Project-Aurora/RainbowFox/RainbowFox.kicad_pcb

## KiCad design RainbowFox.kicad_pcb (2016-12-02)

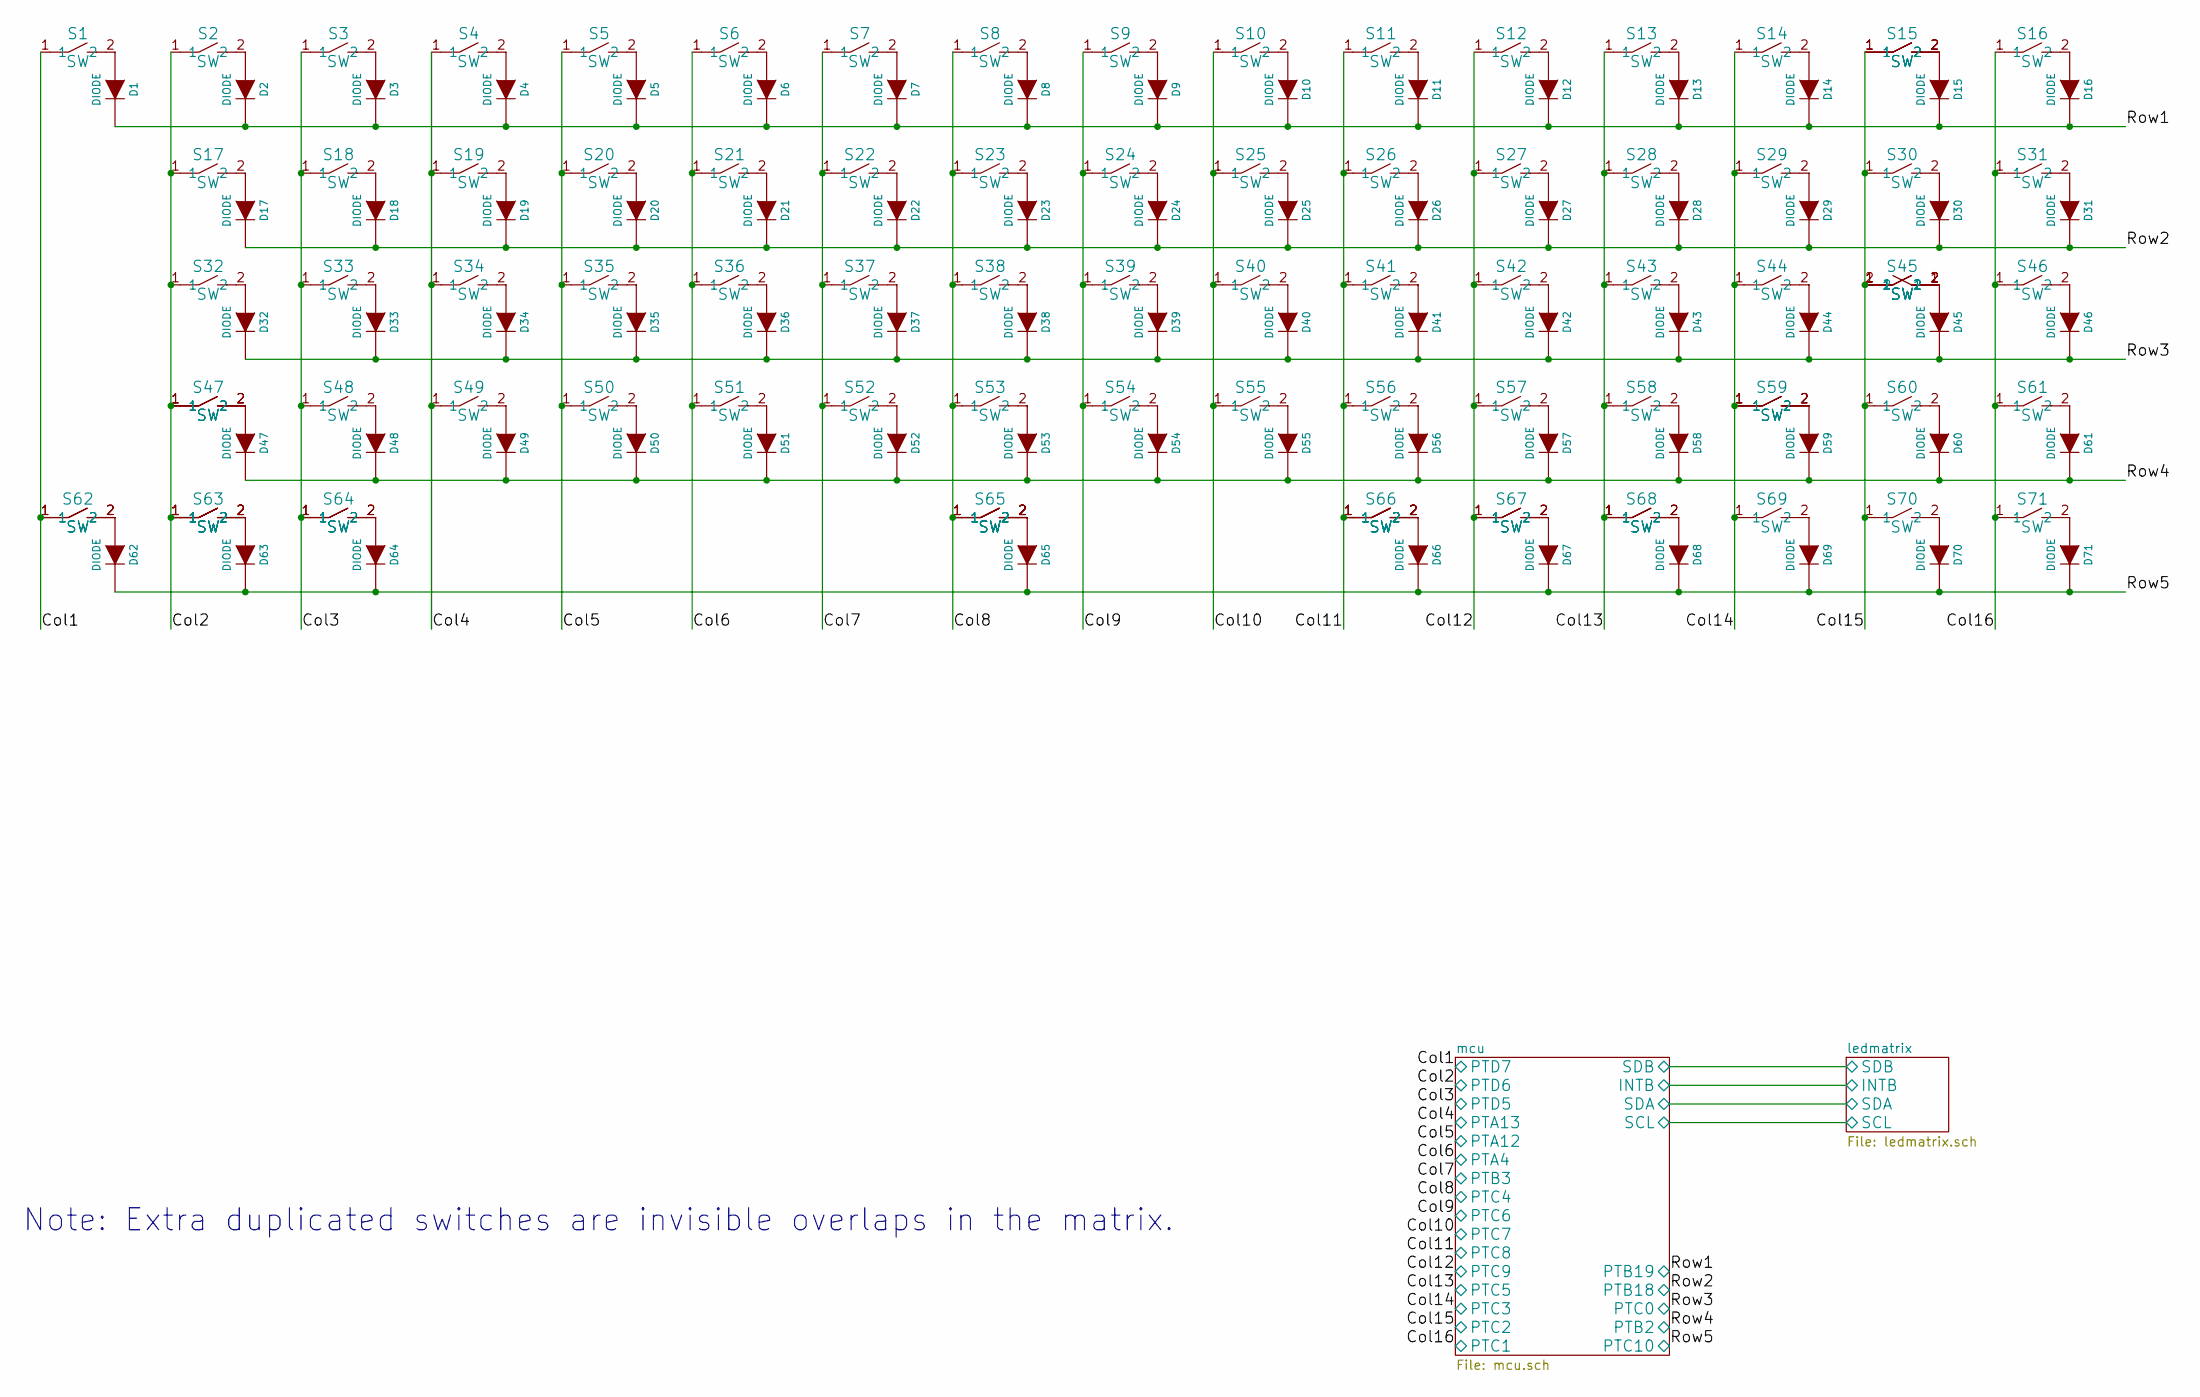
[picture p1: schematic RainbowFox.sch]

Parts:
D1, D2, D3, D4, D5, D6, D7, D8, D9, D10, D11, D12, D13, D14, D15, D16, D17, D18, D19, D20, D21, D22, D23, D24, D25, D26, D27, D28, D29, D30, D31, D32, D33, D34, D35, D36, D37, D38, D39, D40, D41, D42, D43, D44, D45, D46, D47, D48, D49, D50, D51, D52, D53, D54, D55, D56, D57, D58, D59, D60, D61, D62, D63, D64, D65, D66, D67, D68, D69, D70, D71: DIODE; SOD-123
S1, S2, S3, S4, S5, S6, S7, S8, S9, S10, S11, S12, S13, S14, S15, S16, S17, S18, S19, S20, S21, S22, S23, S24, S25, S26, S27, S28, S29, S30, S31, S32, S33, S34, S35, S36, S37, S38, S39, S40, S41, S42, S43, S44, S45, S46, S47, S48, S49, S50, S51, S52, S53, S54, S55, S56, S57, S58, S59, S60, S61, S62, S63, S64, S65, S66, S67, S68, S69, S70, S71: SW; MX1A
S115, S145, S147, S159, S162, S163, S164, S165, S166, S167, S168, S245, S263, S265, S266: SW; MX1A-Borderless

Connections:
/mcu/PTA4: S6.1, S21.1, S36.1, S51.1; also elsewhere on the board
/mcu/PTA12: S5.1, S20.1, S35.1, S50.1; also elsewhere on the board
/mcu/PTA13: S4.1, S19.1, S34.1, S49.1; also elsewhere on the board
/mcu/PTB2: D47.1 (K), D48.1 (K), D49.1 (K), D50.1 (K), D51.1 (K), D52.1 (K), D53.1 (K), D54.1 (K), D55.1 (K), D56.1 (K), D57.1 (K), D58.1 (K), D59.1 (K), D60.1 (K), D61.1 (K); also elsewhere on the board
/mcu/PTB3: S7.1, S22.1, S37.1, S52.1; also elsewhere on the board
/mcu/PTB18: D17.1 (K), D18.1 (K), D19.1 (K), D20.1 (K), D21.1 (K), D22.1 (K), D23.1 (K), D24.1 (K), D25.1 (K), D26.1 (K), D27.1 (K), D28.1 (K), D29.1 (K), D30.1 (K), D31.1 (K); also elsewhere on the board
/mcu/PTB19: D1.1 (K), D2.1 (K), D3.1 (K), D4.1 (K), D5.1 (K), D6.1 (K), D7.1 (K), D8.1 (K), D9.1 (K), D10.1 (K), D11.1 (K), D12.1 (K), D13.1 (K), D14.1 (K), D15.1 (K), D16.1 (K); also elsewhere on the board
/mcu/PTC0: D32.1 (K), D33.1 (K), D34.1 (K), D35.1 (K), D36.1 (K), D37.1 (K), D38.1 (K), D39.1 (K), D40.1 (K), D41.1 (K), D42.1 (K), D43.1 (K), D44.1 (K), D45.1 (K), D46.1 (K); also elsewhere on the board
/mcu/PTC1: S16.1, S31.1, S46.1, S61.1, S71.1; also elsewhere on the board
/mcu/PTC2: S15.1, S30.1, S45.1, S60.1, S70.1, S115.1, S145.1, S245.2; also elsewhere on the board
/mcu/PTC3: S14.1, S29.1, S44.1, S59.1, S69.1, S159.1; also elsewhere on the board
/mcu/PTC4: S8.1, S23.1, S38.1, S53.1, S65.1, S165.1, S265.1; also elsewhere on the board
/mcu/PTC5: S13.1, S28.1, S43.1, S58.1, S68.1, S168.1; also elsewhere on the board
/mcu/PTC6: S9.1, S24.1, S39.1, S54.1; also elsewhere on the board
/mcu/PTC7: S10.1, S25.1, S40.1, S55.1; also elsewhere on the board
/mcu/PTC8: S11.1, S26.1, S41.1, S56.1, S66.1, S166.1, S266.1; also elsewhere on the board
/mcu/PTC9: S12.1, S27.1, S42.1, S57.1, S67.1, S167.1; also elsewhere on the board
/mcu/PTC10: D62.1 (K), D63.1 (K), D64.1 (K), D65.1 (K), D66.1 (K), D67.1 (K), D68.1 (K), D69.1 (K), D70.1 (K), D71.1 (K); also elsewhere on the board
/mcu/PTD5: S3.1, S18.1, S33.1, S48.1, S64.1, S164.1; also elsewhere on the board
/mcu/PTD6: S2.1, S17.1, S32.1, S47.1, S63.1, S147.1, S163.1, S263.1; also elsewhere on the board
/mcu/PTD7: S1.1, S62.1, S162.1; also elsewhere on the board
unnamed: D1.2 (A), S1.2
unnamed: D2.2 (A), S2.2
unnamed: D3.2 (A), S3.2
unnamed: D4.2 (A), S4.2
unnamed: D5.2 (A), S5.2
unnamed: D6.2 (A), S6.2
unnamed: D7.2 (A), S7.2
unnamed: D8.2 (A), S8.2
unnamed: D9.2 (A), S9.2
unnamed: D10.2 (A), S10.2
unnamed: D11.2 (A), S11.2
unnamed: D12.2 (A), S12.2
unnamed: D13.2 (A), S13.2
unnamed: D14.2 (A), S14.2
unnamed: D15.2 (A), S15.2, S115.2
unnamed: D16.2 (A), S16.2
unnamed: D17.2 (A), S17.2
unnamed: D18.2 (A), S18.2
unnamed: D19.2 (A), S19.2
unnamed: D20.2 (A), S20.2
unnamed: D21.2 (A), S21.2
unnamed: D22.2 (A), S22.2
unnamed: D23.2 (A), S23.2
unnamed: D24.2 (A), S24.2
unnamed: D25.2 (A), S25.2
unnamed: D26.2 (A), S26.2
unnamed: D27.2 (A), S27.2
unnamed: D28.2 (A), S28.2
unnamed: D29.2 (A), S29.2
unnamed: D30.2 (A), S30.2
unnamed: D31.2 (A), S31.2
unnamed: D32.2 (A), S32.2
unnamed: D33.2 (A), S33.2
unnamed: D34.2 (A), S34.2
unnamed: D35.2 (A), S35.2
unnamed: D36.2 (A), S36.2
unnamed: D37.2 (A), S37.2
unnamed: D38.2 (A), S38.2
unnamed: D39.2 (A), S39.2
unnamed: D40.2 (A), S40.2
unnamed: D41.2 (A), S41.2
unnamed: D42.2 (A), S42.2
unnamed: D43.2 (A), S43.2
unnamed: D44.2 (A), S44.2
unnamed: D45.2 (A), S45.2, S145.2, S245.1
unnamed: D46.2 (A), S46.2
unnamed: D47.2 (A), S47.2, S147.2
unnamed: D48.2 (A), S48.2
unnamed: D49.2 (A), S49.2
unnamed: D50.2 (A), S50.2
unnamed: D51.2 (A), S51.2
unnamed: D52.2 (A), S52.2
unnamed: D53.2 (A), S53.2
unnamed: D54.2 (A), S54.2
unnamed: D55.2 (A), S55.2
unnamed: D56.2 (A), S56.2
unnamed: D57.2 (A), S57.2
unnamed: D58.2 (A), S58.2
unnamed: D59.2 (A), S59.2, S159.2
unnamed: D60.2 (A), S60.2
unnamed: D61.2 (A), S61.2
unnamed: D62.2 (A), S62.2, S162.2
unnamed: D63.2 (A), S63.2, S163.2, S263.2
unnamed: D64.2 (A), S64.2, S164.2
unnamed: D65.2 (A), S65.2, S165.2, S265.2
unnamed: D66.2 (A), S66.2, S166.2, S266.2
unnamed: D67.2 (A), S67.2, S167.2
unnamed: D68.2 (A), S68.2, S168.2
unnamed: D69.2 (A), S69.2
unnamed: D70.2 (A), S70.2
unnamed: D71.2 (A), S71.2

Notes on the sheet:
Note: Extra duplicated switches are invisible overlaps in the matrix.

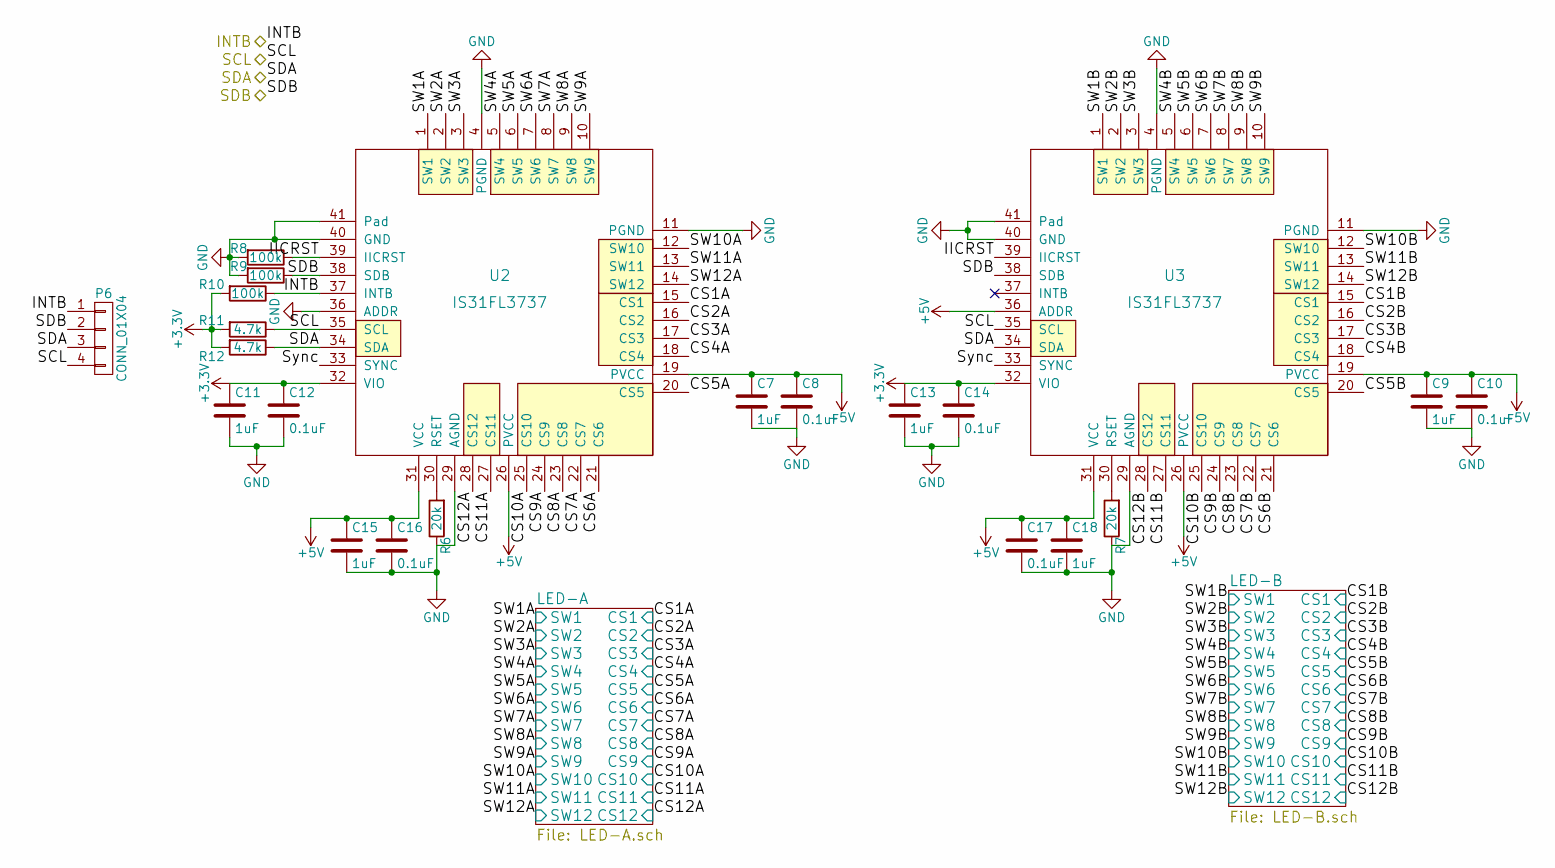
[picture p2: schematic ledmatrix.sch, RainbowFox]

Parts:
C7, C9, C11, C13, C15, C18: 1uF; C_0603
C8, C10, C12, C14, C16, C17: 0.1uF; C_0603
P6: CONN_01X04; Conn-4
R6, R7: 20k; R_0603
R8, R9, R10: 100k; R_0603
R11, R12: 4.7k; R_0603
U2, U3: IS31FL3737; UQFN-40-1EP_5x5mm_Pitch0.4mm

Connections:
+3V3: C11.1, C12.1, C13.1, C14.1, R10.2, R11.2, R12.2, U2.32 (VIO), U3.32 (VIO); also elsewhere on the board
+5V: C7.1, C8.1, C9.1, C10.1, C15.1, C16.1, C17.1, C18.1, U2.19 (PVCC), U2.26 (PVCC), U2.31 (VCC), U3.19 (PVCC), U3.26 (PVCC), U3.31 (VCC), U3.36 (ADDR); also elsewhere on the board
/ledmatrix/IICRST: R8.1, U2.39 (IICRST), U3.39 (IICRST)
/ledmatrix/INTB: P6.1, R10.1, U2.37 (INTB); also elsewhere on the board
/ledmatrix/LED-A/CS1: U2.15 (CS1); also elsewhere on the board
/ledmatrix/LED-A/CS2: U2.16 (CS2); also elsewhere on the board
/ledmatrix/LED-A/CS3: U2.17 (CS3); also elsewhere on the board
/ledmatrix/LED-A/CS4: U2.18 (CS4); also elsewhere on the board
/ledmatrix/LED-A/CS5: U2.20 (CS5); also elsewhere on the board
/ledmatrix/LED-A/CS6: U2.21 (CS6); also elsewhere on the board
/ledmatrix/LED-A/CS7: U2.22 (CS7); also elsewhere on the board
/ledmatrix/LED-A/CS8: U2.23 (CS8); also elsewhere on the board
/ledmatrix/LED-A/CS9: U2.24 (CS9); also elsewhere on the board
/ledmatrix/LED-A/SW1: U2.1 (SW1); also elsewhere on the board
/ledmatrix/LED-A/SW2: U2.2 (SW2); also elsewhere on the board
/ledmatrix/LED-A/SW3: U2.3 (SW3); also elsewhere on the board
/ledmatrix/LED-A/SW4: U2.5 (SW4); also elsewhere on the board
/ledmatrix/LED-A/SW5: U2.6 (SW5); also elsewhere on the board
/ledmatrix/LED-A/SW6: U2.7 (SW6); also elsewhere on the board
/ledmatrix/LED-A/SW7: U2.8 (SW7); also elsewhere on the board
/ledmatrix/LED-A/SW8: U2.9 (SW8); also elsewhere on the board
/ledmatrix/LED-A/SW9: U2.10 (SW9); also elsewhere on the board
/ledmatrix/LED-A/SW10: U2.12 (SW10); also elsewhere on the board
/ledmatrix/LED-A/SW11: U2.13 (SW11); also elsewhere on the board
/ledmatrix/LED-A/SW12: U2.14 (SW12); also elsewhere on the board
/ledmatrix/LED-B/CS1: U3.15 (CS1); also elsewhere on the board
/ledmatrix/LED-B/CS2: U3.16 (CS2); also elsewhere on the board
/ledmatrix/LED-B/CS3: U3.17 (CS3); also elsewhere on the board
/ledmatrix/LED-B/CS4: U3.18 (CS4); also elsewhere on the board
/ledmatrix/LED-B/CS5: U3.20 (CS5); also elsewhere on the board
/ledmatrix/LED-B/CS6: U3.21 (CS6); also elsewhere on the board
/ledmatrix/LED-B/CS7: U3.22 (CS7); also elsewhere on the board
/ledmatrix/LED-B/CS8: U3.23 (CS8); also elsewhere on the board
/ledmatrix/LED-B/CS9: U3.24 (CS9); also elsewhere on the board
/ledmatrix/LED-B/CS10: U3.25 (CS10); also elsewhere on the board
/ledmatrix/LED-B/SW1: U3.1 (SW1); also elsewhere on the board
/ledmatrix/LED-B/SW2: U3.2 (SW2); also elsewhere on the board
/ledmatrix/LED-B/SW3: U3.3 (SW3); also elsewhere on the board
/ledmatrix/LED-B/SW4: U3.5 (SW4); also elsewhere on the board
/ledmatrix/LED-B/SW5: U3.6 (SW5); also elsewhere on the board
/ledmatrix/LED-B/SW6: U3.7 (SW6); also elsewhere on the board
/ledmatrix/LED-B/SW7: U3.8 (SW7); also elsewhere on the board
/ledmatrix/LED-B/SW8: U3.9 (SW8); also elsewhere on the board
/ledmatrix/LED-B/SW9: U3.10 (SW9); also elsewhere on the board
/ledmatrix/LED-B/SW10: U3.12 (SW10); also elsewhere on the board
/ledmatrix/LED-B/SW11: U3.13 (SW11); also elsewhere on the board
/ledmatrix/LED-B/SW12: U3.14 (SW12); also elsewhere on the board
/ledmatrix/SCL: P6.4, R11.1, U2.35 (SCL), U3.35 (SCL); also elsewhere on the board
/ledmatrix/SDA: P6.3, R12.1, U2.34 (SDA), U3.34 (SDA); also elsewhere on the board
/ledmatrix/SDB: P6.2, R9.1, U2.38 (SDB), U3.38 (SDB); also elsewhere on the board
/ledmatrix/Sync: U2.33 (SYNC), U3.33 (SYNC)
GND: C7.2, C8.2, C9.2, C10.2, C11.2, C12.2, C13.2, C14.2, C15.2, C16.2, C17.2, C18.2, R6.1, R7.1, R8.2, R9.2, U2.4 (PGND), U2.11 (PGND), U2.29 (AGND), U2.36 (ADDR), U2.40 (GND), U2.41 (Pad), U3.4 (PGND), U3.11 (PGND), U3.29 (AGND), U3.40 (GND), U3.41 (Pad); also elsewhere on the board
unnamed: R6.2, U2.30 (RSET)
unnamed: R7.2, U3.30 (RSET)

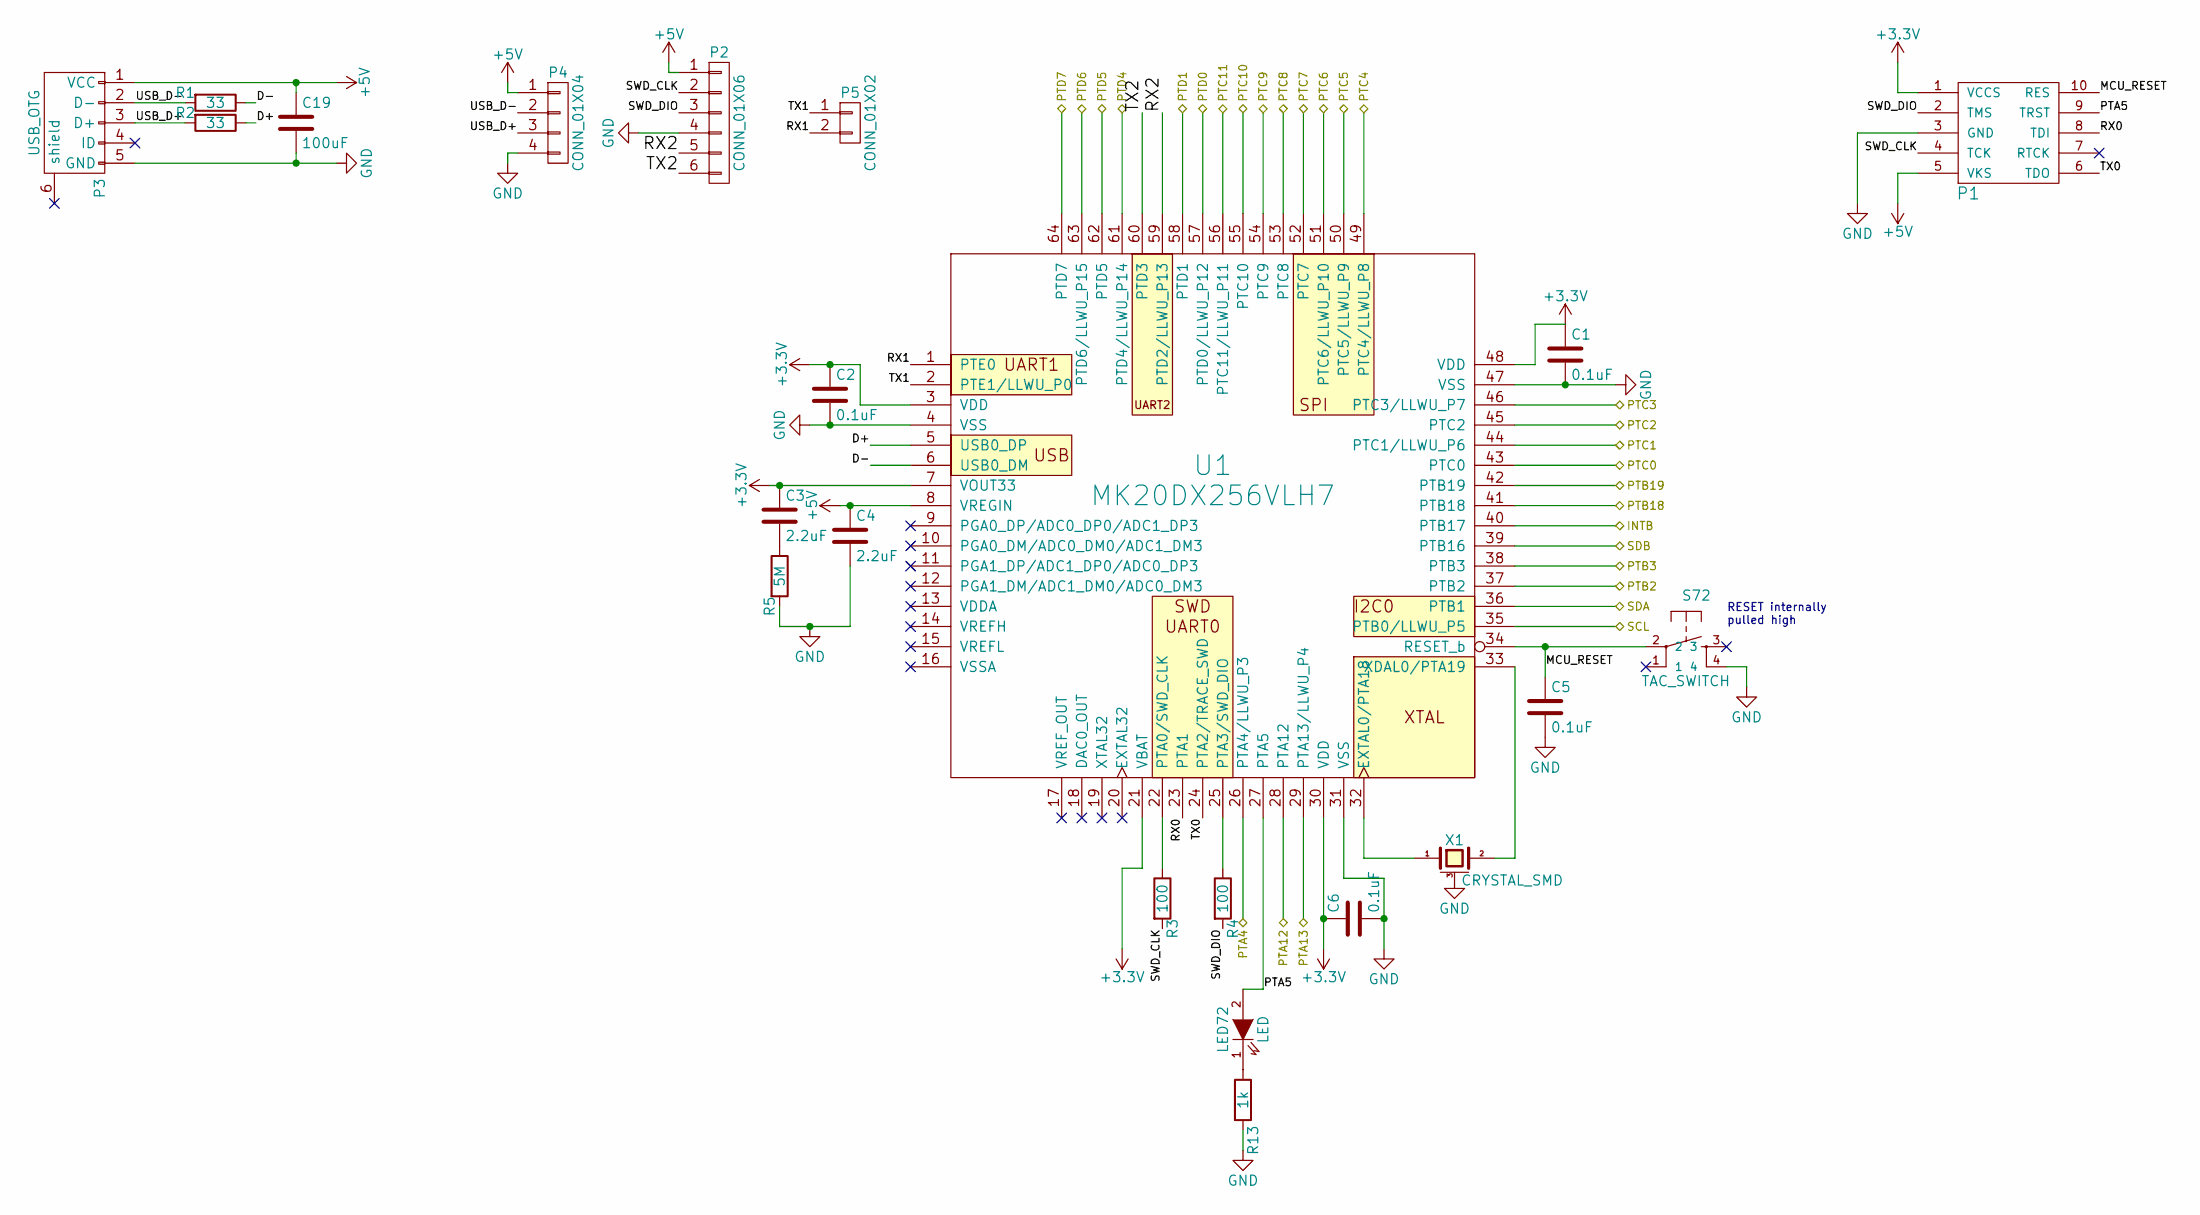
[picture p3: schematic mcu.sch, RainbowFox]

Parts:
C1, C2, C5, C6: 0.1uF; C_0603
C3, C4: 2.2uF; C_0603
C19: 100uF; C_1206
LED72: LED; LED_0805
P1: FLASH_HDR; JLINK_NEEDLE
P2: CONN_01X06; Conn-6
P3: USB_OTG; Micro-USB_629105150521
P4: CONN_01X04; Conn-4
P5: CONN_01X02; Conn-2
R1, R2: 33; R_0603
R3, R4: 100; R_0603
R5: 5M; R_0805
R13: 1k; R_0603
S72: TAC_SWITCH; PTS810
U1: MK20DX256VLH7; LQFP-64_10x10mm_Pitch0.5mm
X1: CRYSTAL_SMD; crystal_FA238-TSX3225

Connections:
+3V3: C1.1, C2.1, C3.1, C6.1, P1.1 (VCCS), U1.3 (VDD), U1.7 (VOUT33), U1.21 (VBAT), U1.30 (VDD), U1.48 (VDD); also elsewhere on the board
+5V: C4.1, C19.1, P1.5 (VKS), P2.1, P3.1 (VCC), P4.1, U1.8 (VREGIN); also elsewhere on the board
/ledmatrix/INTB: U1.40 (PTB17); also elsewhere on the board
/ledmatrix/SCL: U1.35 (PTB0/LLWU_P5); also elsewhere on the board
/ledmatrix/SDA: U1.36 (PTB1); also elsewhere on the board
/ledmatrix/SDB: U1.39 (PTB16); also elsewhere on the board
/mcu/D+: R2.1, U1.5 (USB0_DP)
/mcu/D-: R1.1, U1.6 (USB0_DM)
/mcu/MCU_RESET: C5.1, P1.10 (RES), S72.2, U1.34 (RESET_b)
/mcu/PTA4: U1.26 (PTA4/LLWU_P3); also elsewhere on the board
/mcu/PTA5: LED72.2 (A), P1.9 (TRST), U1.27 (PTA5)
/mcu/PTA12: U1.28 (PTA12); also elsewhere on the board
/mcu/PTA13: U1.29 (PTA13/LLWU_P4); also elsewhere on the board
/mcu/PTB2: U1.37 (PTB2); also elsewhere on the board
/mcu/PTB3: U1.38 (PTB3); also elsewhere on the board
/mcu/PTB18: U1.41 (PTB18); also elsewhere on the board
/mcu/PTB19: U1.42 (PTB19); also elsewhere on the board
/mcu/PTC0: U1.43 (PTC0); also elsewhere on the board
/mcu/PTC1: U1.44 (PTC1/LLWU_P6); also elsewhere on the board
/mcu/PTC2: U1.45 (PTC2); also elsewhere on the board
/mcu/PTC3: U1.46 (PTC3/LLWU_P7); also elsewhere on the board
/mcu/PTC4: U1.49 (PTC4/LLWU_P8); also elsewhere on the board
/mcu/PTC5: U1.50 (PTC5/LLWU_P9); also elsewhere on the board
/mcu/PTC6: U1.51 (PTC6/LLWU_P10); also elsewhere on the board
/mcu/PTC7: U1.52 (PTC7); also elsewhere on the board
/mcu/PTC8: U1.53 (PTC8); also elsewhere on the board
/mcu/PTC9: U1.54 (PTC9); also elsewhere on the board
/mcu/PTC10: U1.55 (PTC10); also elsewhere on the board
/mcu/PTD5: U1.62 (PTD5); also elsewhere on the board
/mcu/PTD6: U1.63 (PTD6/LLWU_P15); also elsewhere on the board
/mcu/PTD7: U1.64 (PTD7); also elsewhere on the board
/mcu/RX0: P1.8 (TDI), U1.23 (PTA1)
/mcu/RX1: P5.2, U1.1 (PTE0)
/mcu/RX2: P2.5, U1.59 (PTD2/LLWU_P13)
/mcu/SWD_CLK: P1.4 (TCK), P2.2, R3.2
/mcu/SWD_DIO: P1.2 (TMS), P2.3, R4.2
/mcu/TX0: P1.6 (TDO), U1.24 (PTA2/TRACE_SWD)
/mcu/TX1: P5.1, U1.2 (PTE1/LLWU_P0)
/mcu/TX2: P2.6, U1.60 (PTD3)
/mcu/USB_D+: P3.3 (D+), P4.3, R2.2
/mcu/USB_D-: P3.2 (D-), P4.2, R1.2
GND: C1.2, C2.2, C4.2, C5.2, C6.2, C19.2, P1.3 (GND), P2.4, P3.5 (GND), P4.4, R5.2, R13.2, S72.4, U1.4 (VSS), U1.31 (VSS), U1.47 (VSS), X1.3 (case); also elsewhere on the board
unnamed: C3.2, R5.1
unnamed: LED72.1 (K), R13.1
unnamed: R3.1, U1.22 (PTA0/SWD_CLK)
unnamed: R4.1, U1.25 (PTA3/SWD_DIO)
unnamed: U1.32 (EXTAL0/PTA18), X1.1
unnamed: U1.33 (XDAL0/PTA19), X1.2

Notes on the sheet:
RESET internally pulled high

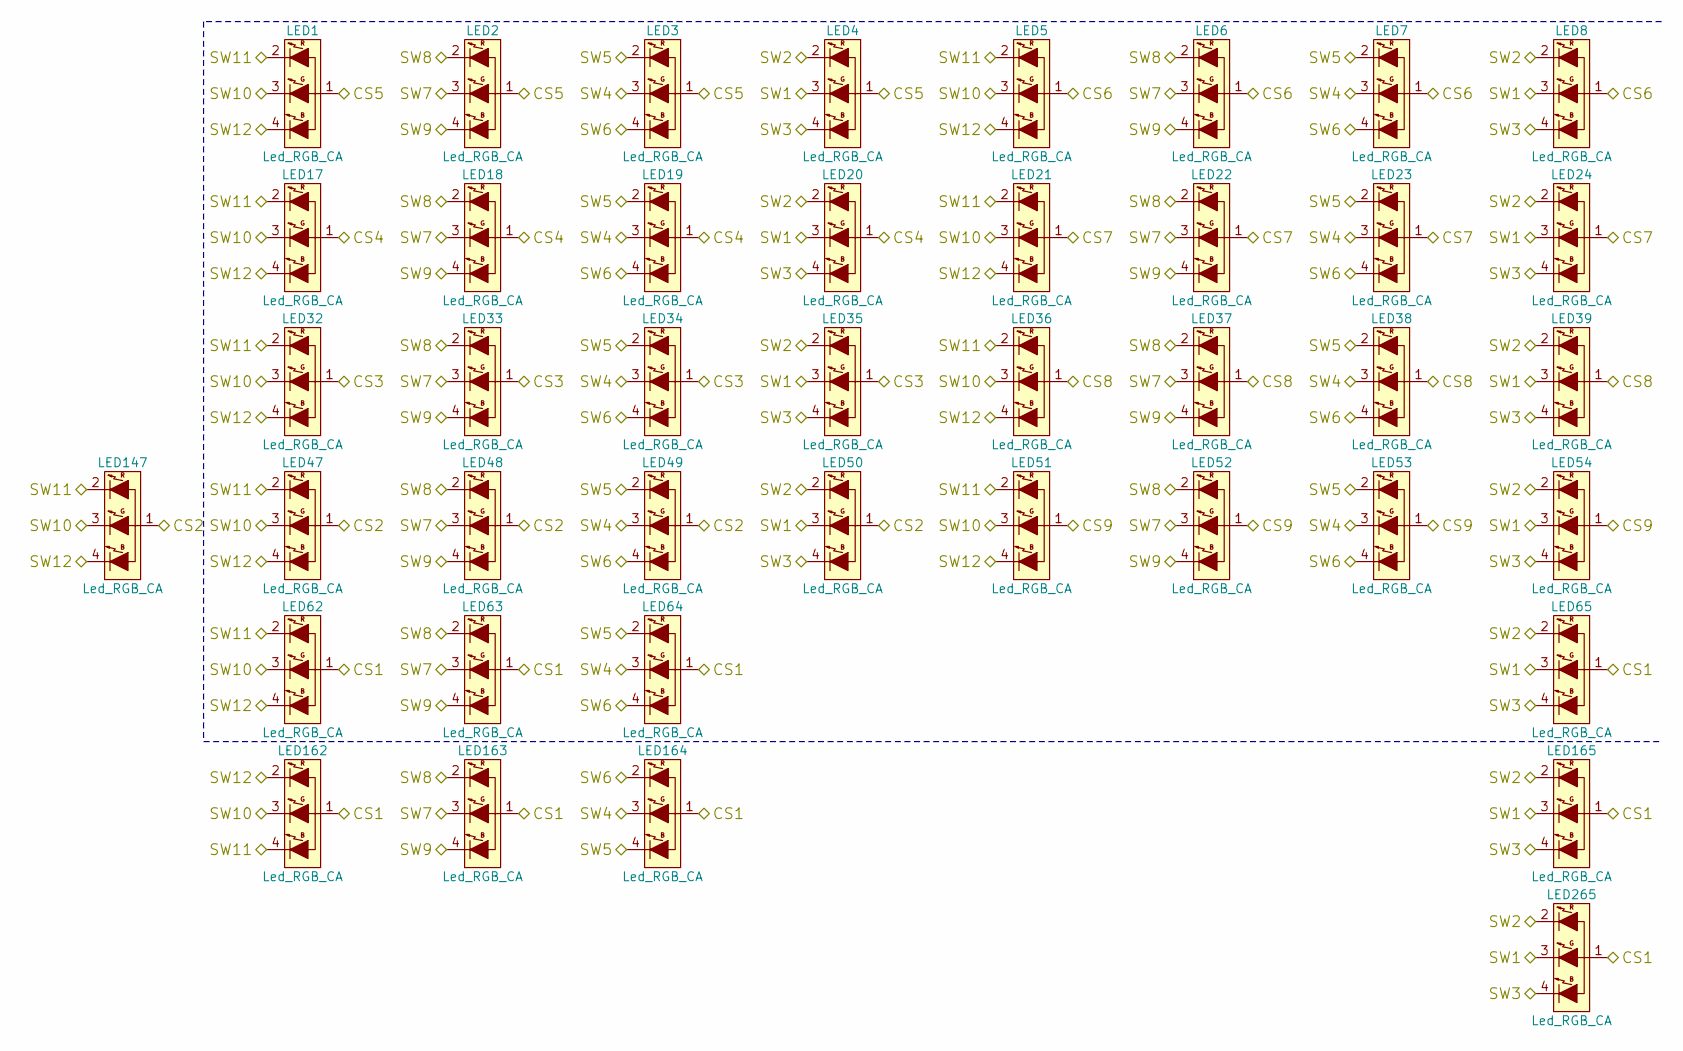
[picture p4: schematic LED-A.sch]

Parts:
LED1, LED2, LED3, LED4, LED5, LED6, LED7, LED8, LED17, LED18, LED19, LED20, LED21, LED22, LED23, LED24, LED32, LED33, LED34, LED35, LED36, LED37, LED38, LED39, LED47, LED48, LED49, LED50, LED51, LED52, LED53, LED54, LED62, LED63, LED64, LED65, LED147, LED165: Led_RGB_CA; RGB
LED162, LED163, LED164, LED265: Led_RGB_CA; RGB-reverse

Connections:
/ledmatrix/LED-A/CS1: LED62.1, LED63.1, LED64.1, LED65.1, LED162.1, LED163.1, LED164.1, LED165.1, LED265.1; also elsewhere on the board
/ledmatrix/LED-A/CS2: LED47.1, LED48.1, LED49.1, LED50.1, LED147.1; also elsewhere on the board
/ledmatrix/LED-A/CS3: LED32.1, LED33.1, LED34.1, LED35.1; also elsewhere on the board
/ledmatrix/LED-A/CS4: LED17.1, LED18.1, LED19.1, LED20.1; also elsewhere on the board
/ledmatrix/LED-A/CS5: LED1.1, LED2.1, LED3.1, LED4.1; also elsewhere on the board
/ledmatrix/LED-A/CS6: LED5.1, LED6.1, LED7.1, LED8.1; also elsewhere on the board
/ledmatrix/LED-A/CS7: LED21.1, LED22.1, LED23.1, LED24.1; also elsewhere on the board
/ledmatrix/LED-A/CS8: LED36.1, LED37.1, LED38.1, LED39.1; also elsewhere on the board
/ledmatrix/LED-A/CS9: LED51.1, LED52.1, LED53.1, LED54.1; also elsewhere on the board
/ledmatrix/LED-A/SW1: LED4.3 (G), LED8.3 (G), LED20.3 (G), LED24.3 (G), LED35.3 (G), LED39.3 (G), LED50.3 (G), LED54.3 (G), LED65.3 (G), LED165.3 (G), LED265.3 (G); also elsewhere on the board
/ledmatrix/LED-A/SW2: LED4.2 (R), LED8.2 (R), LED20.2 (R), LED24.2 (R), LED35.2 (R), LED39.2 (R), LED50.2 (R), LED54.2 (R), LED65.2 (R), LED165.2 (R), LED265.2 (R); also elsewhere on the board
/ledmatrix/LED-A/SW3: LED4.4 (B), LED8.4 (B), LED20.4 (B), LED24.4 (B), LED35.4 (B), LED39.4 (B), LED50.4 (B), LED54.4 (B), LED65.4 (B), LED165.4 (B), LED265.4 (B); also elsewhere on the board
/ledmatrix/LED-A/SW4: LED3.3 (G), LED7.3 (G), LED19.3 (G), LED23.3 (G), LED34.3 (G), LED38.3 (G), LED49.3 (G), LED53.3 (G), LED64.3 (G), LED164.3 (G); also elsewhere on the board
/ledmatrix/LED-A/SW5: LED3.2 (R), LED7.2 (R), LED19.2 (R), LED23.2 (R), LED34.2 (R), LED38.2 (R), LED49.2 (R), LED53.2 (R), LED64.2 (R), LED164.4 (B); also elsewhere on the board
/ledmatrix/LED-A/SW6: LED3.4 (B), LED7.4 (B), LED19.4 (B), LED23.4 (B), LED34.4 (B), LED38.4 (B), LED49.4 (B), LED53.4 (B), LED64.4 (B), LED164.2 (R); also elsewhere on the board
/ledmatrix/LED-A/SW7: LED2.3 (G), LED6.3 (G), LED18.3 (G), LED22.3 (G), LED33.3 (G), LED37.3 (G), LED48.3 (G), LED52.3 (G), LED63.3 (G), LED163.3 (G); also elsewhere on the board
/ledmatrix/LED-A/SW8: LED2.2 (R), LED6.2 (R), LED18.2 (R), LED22.2 (R), LED33.2 (R), LED37.2 (R), LED48.2 (R), LED52.2 (R), LED63.2 (R), LED163.2 (R); also elsewhere on the board
/ledmatrix/LED-A/SW9: LED2.4 (B), LED6.4 (B), LED18.4 (B), LED22.4 (B), LED33.4 (B), LED37.4 (B), LED48.4 (B), LED52.4 (B), LED63.4 (B), LED163.4 (B); also elsewhere on the board
/ledmatrix/LED-A/SW10: LED1.3 (G), LED5.3 (G), LED17.3 (G), LED21.3 (G), LED32.3 (G), LED36.3 (G), LED47.3 (G), LED51.3 (G), LED62.3 (G), LED147.3 (G), LED162.3 (G); also elsewhere on the board
/ledmatrix/LED-A/SW11: LED1.2 (R), LED5.2 (R), LED17.2 (R), LED21.2 (R), LED32.2 (R), LED36.2 (R), LED47.2 (R), LED51.2 (R), LED62.2 (R), LED147.2 (R), LED162.4 (B); also elsewhere on the board
/ledmatrix/LED-A/SW12: LED1.4 (B), LED5.4 (B), LED17.4 (B), LED21.4 (B), LED32.4 (B), LED36.4 (B), LED47.4 (B), LED51.4 (B), LED62.4 (B), LED147.4 (B), LED162.2 (R); also elsewhere on the board

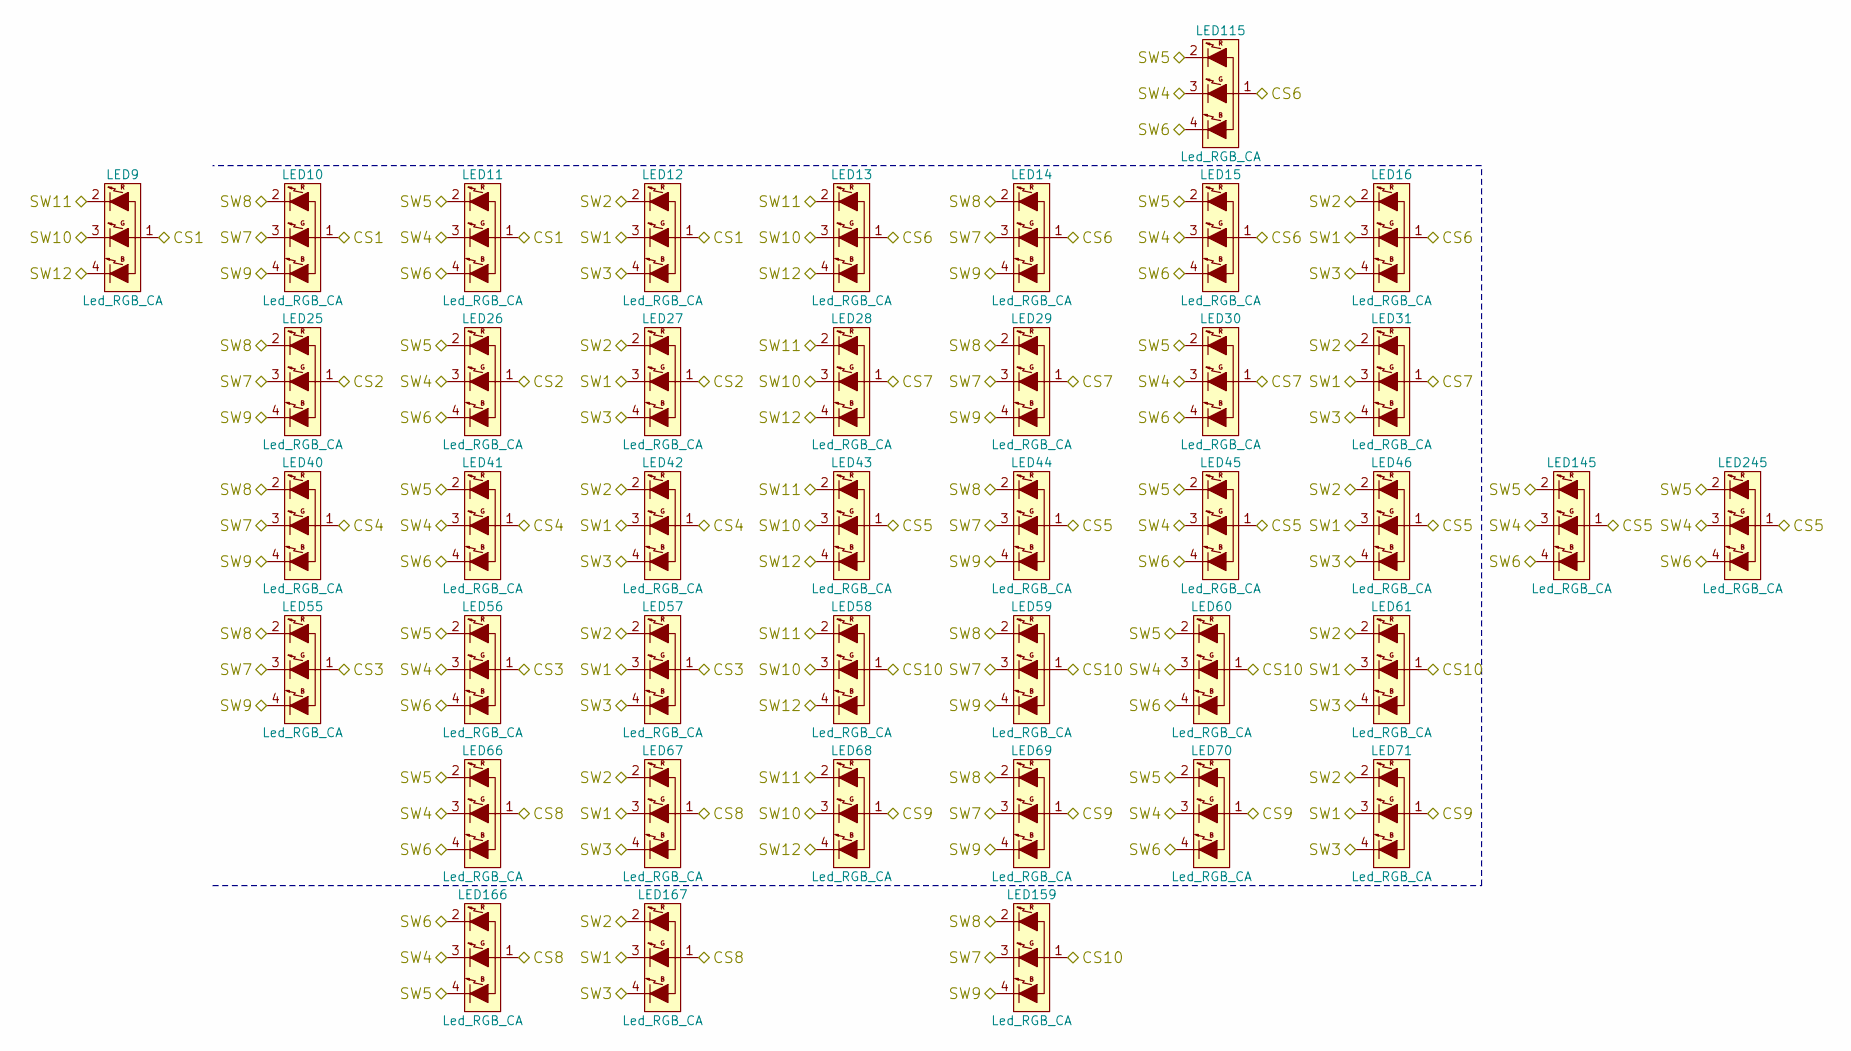
[picture p5: schematic LED-B.sch]

Parts:
LED9, LED10, LED11, LED12, LED13, LED14, LED15, LED16, LED25, LED26, LED27, LED28, LED29, LED30, LED31, LED40, LED41, LED42, LED43, LED44, LED45, LED46, LED55, LED56, LED57, LED58, LED59, LED60, LED61, LED66, LED67, LED68, LED69, LED70, LED71, LED115, LED145, LED159: Led_RGB_CA; RGB
LED166, LED167, LED245: Led_RGB_CA; RGB-reverse

Connections:
/ledmatrix/LED-B/CS1: LED9.1, LED10.1, LED11.1, LED12.1; also elsewhere on the board
/ledmatrix/LED-B/CS2: LED25.1, LED26.1, LED27.1; also elsewhere on the board
/ledmatrix/LED-B/CS3: LED55.1, LED56.1, LED57.1; also elsewhere on the board
/ledmatrix/LED-B/CS4: LED40.1, LED41.1, LED42.1; also elsewhere on the board
/ledmatrix/LED-B/CS5: LED43.1, LED44.1, LED45.1, LED46.1, LED145.1, LED245.1; also elsewhere on the board
/ledmatrix/LED-B/CS6: LED13.1, LED14.1, LED15.1, LED16.1, LED115.1; also elsewhere on the board
/ledmatrix/LED-B/CS7: LED28.1, LED29.1, LED30.1, LED31.1; also elsewhere on the board
/ledmatrix/LED-B/CS8: LED66.1, LED67.1, LED166.1, LED167.1; also elsewhere on the board
/ledmatrix/LED-B/CS9: LED68.1, LED69.1, LED70.1, LED71.1; also elsewhere on the board
/ledmatrix/LED-B/CS10: LED58.1, LED59.1, LED60.1, LED61.1, LED159.1; also elsewhere on the board
/ledmatrix/LED-B/SW1: LED12.3 (G), LED16.3 (G), LED27.3 (G), LED31.3 (G), LED42.3 (G), LED46.3 (G), LED57.3 (G), LED61.3 (G), LED67.3 (G), LED71.3 (G), LED167.3 (G); also elsewhere on the board
/ledmatrix/LED-B/SW2: LED12.2 (R), LED16.2 (R), LED27.2 (R), LED31.2 (R), LED42.2 (R), LED46.2 (R), LED57.2 (R), LED61.2 (R), LED67.2 (R), LED71.2 (R), LED167.2 (R); also elsewhere on the board
/ledmatrix/LED-B/SW3: LED12.4 (B), LED16.4 (B), LED27.4 (B), LED31.4 (B), LED42.4 (B), LED46.4 (B), LED57.4 (B), LED61.4 (B), LED67.4 (B), LED71.4 (B), LED167.4 (B); also elsewhere on the board
/ledmatrix/LED-B/SW4: LED11.3 (G), LED15.3 (G), LED26.3 (G), LED30.3 (G), LED41.3 (G), LED45.3 (G), LED56.3 (G), LED60.3 (G), LED66.3 (G), LED70.3 (G), LED115.3 (G), LED145.3 (G), LED166.3 (G), LED245.3 (G); also elsewhere on the board
/ledmatrix/LED-B/SW5: LED11.2 (R), LED15.2 (R), LED26.2 (R), LED30.2 (R), LED41.2 (R), LED45.2 (R), LED56.2 (R), LED60.2 (R), LED66.2 (R), LED70.2 (R), LED115.2 (R), LED145.2 (R), LED166.4 (B), LED245.2 (R); also elsewhere on the board
/ledmatrix/LED-B/SW6: LED11.4 (B), LED15.4 (B), LED26.4 (B), LED30.4 (B), LED41.4 (B), LED45.4 (B), LED56.4 (B), LED60.4 (B), LED66.4 (B), LED70.4 (B), LED115.4 (B), LED145.4 (B), LED166.2 (R), LED245.4 (B); also elsewhere on the board
/ledmatrix/LED-B/SW7: LED10.3 (G), LED14.3 (G), LED25.3 (G), LED29.3 (G), LED40.3 (G), LED44.3 (G), LED55.3 (G), LED59.3 (G), LED69.3 (G), LED159.3 (G); also elsewhere on the board
/ledmatrix/LED-B/SW8: LED10.2 (R), LED14.2 (R), LED25.2 (R), LED29.2 (R), LED40.2 (R), LED44.2 (R), LED55.2 (R), LED59.2 (R), LED69.2 (R), LED159.2 (R); also elsewhere on the board
/ledmatrix/LED-B/SW9: LED10.4 (B), LED14.4 (B), LED25.4 (B), LED29.4 (B), LED40.4 (B), LED44.4 (B), LED55.4 (B), LED59.4 (B), LED69.4 (B), LED159.4 (B); also elsewhere on the board
/ledmatrix/LED-B/SW10: LED9.3 (G), LED13.3 (G), LED28.3 (G), LED43.3 (G), LED58.3 (G), LED68.3 (G); also elsewhere on the board
/ledmatrix/LED-B/SW11: LED9.2 (R), LED13.2 (R), LED28.2 (R), LED43.2 (R), LED58.2 (R), LED68.2 (R); also elsewhere on the board
/ledmatrix/LED-B/SW12: LED9.4 (B), LED13.4 (B), LED28.4 (B), LED43.4 (B), LED58.4 (B), LED68.4 (B); also elsewhere on the board
