Project-Aurora/RainbowFox/RainbowFox.kicad_pcb

## KiCad design RainbowFox.kicad_pcb (continued)

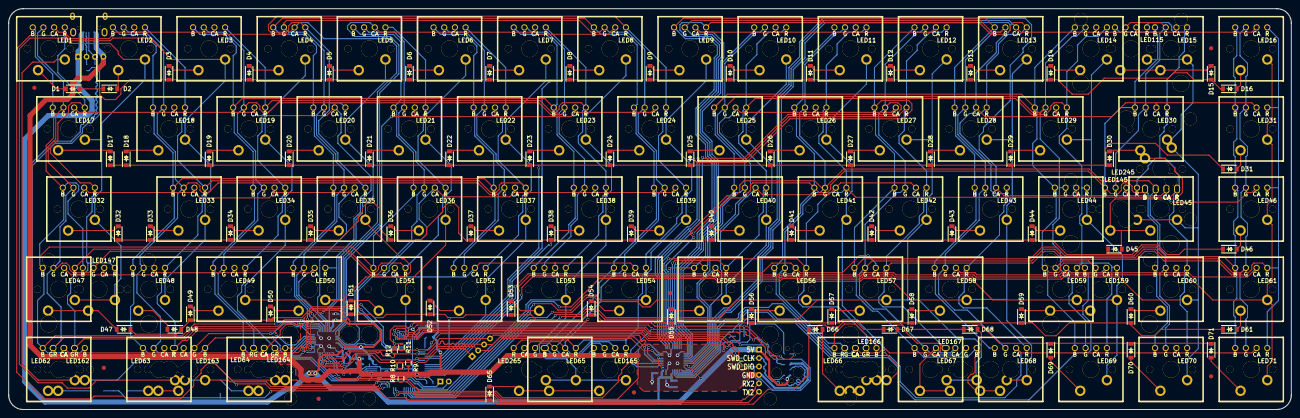
[picture p6: board RainbowFox.kicad_pcb from above]

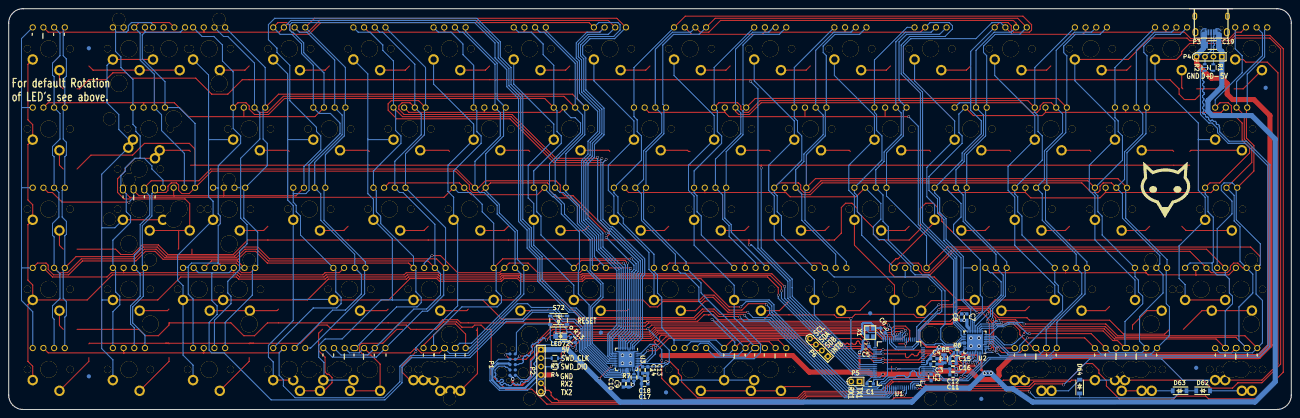
[picture p7: board RainbowFox.kicad_pcb from below]

Board: 2 copper layers, 304.8 x 95.3 mm, 299 parts (42 on the bottom side), 166 nets.

Other parts of the board:
STAB1, STAB2, STAB3, STAB4, STAB5, STAB6, STAB7, STAB8, STAB9, STAB10, STAB11, STAB12, STAB13, STAB14, STAB15: STAB
