Project-Aurora/RainbowFox/(commit log)

2016-06-26 Fixed Orientation of Keyboard-Diodes
    [RainbowFox.kicad_pcb]
2016-07-10 Did some cleanup
    [RainbowFox.kicad_pcb]
2016-08-14 Switched to different Debug Ports
    [RainbowFox.kicad_pcb, RainbowFox.sch, ledmatrix.sch, mcu.sch]
2016-11-30 Addressed the Points raised in Issue #2
    Added Resistor to ground for firmware-LED
    Connect VBAT to 3.3V
    [RainbowFox.kicad_pcb, ledmatrix.sch, mcu.sch]
2016-12-01 Properly replaced the Footprint of the Reset Switch
    [RainbowFox.kicad_pcb]
2016-12-02 Replaced GND with CA in LED Silkscreen
    [RainbowFox.kicad_pcb]
